dmitryshagin/gamma_5_bluetooth/hardware/wheel_decoder/decoder.brd

## EAGLE design hardware/wheel_decoder/decoder.brd (2017-07-10)

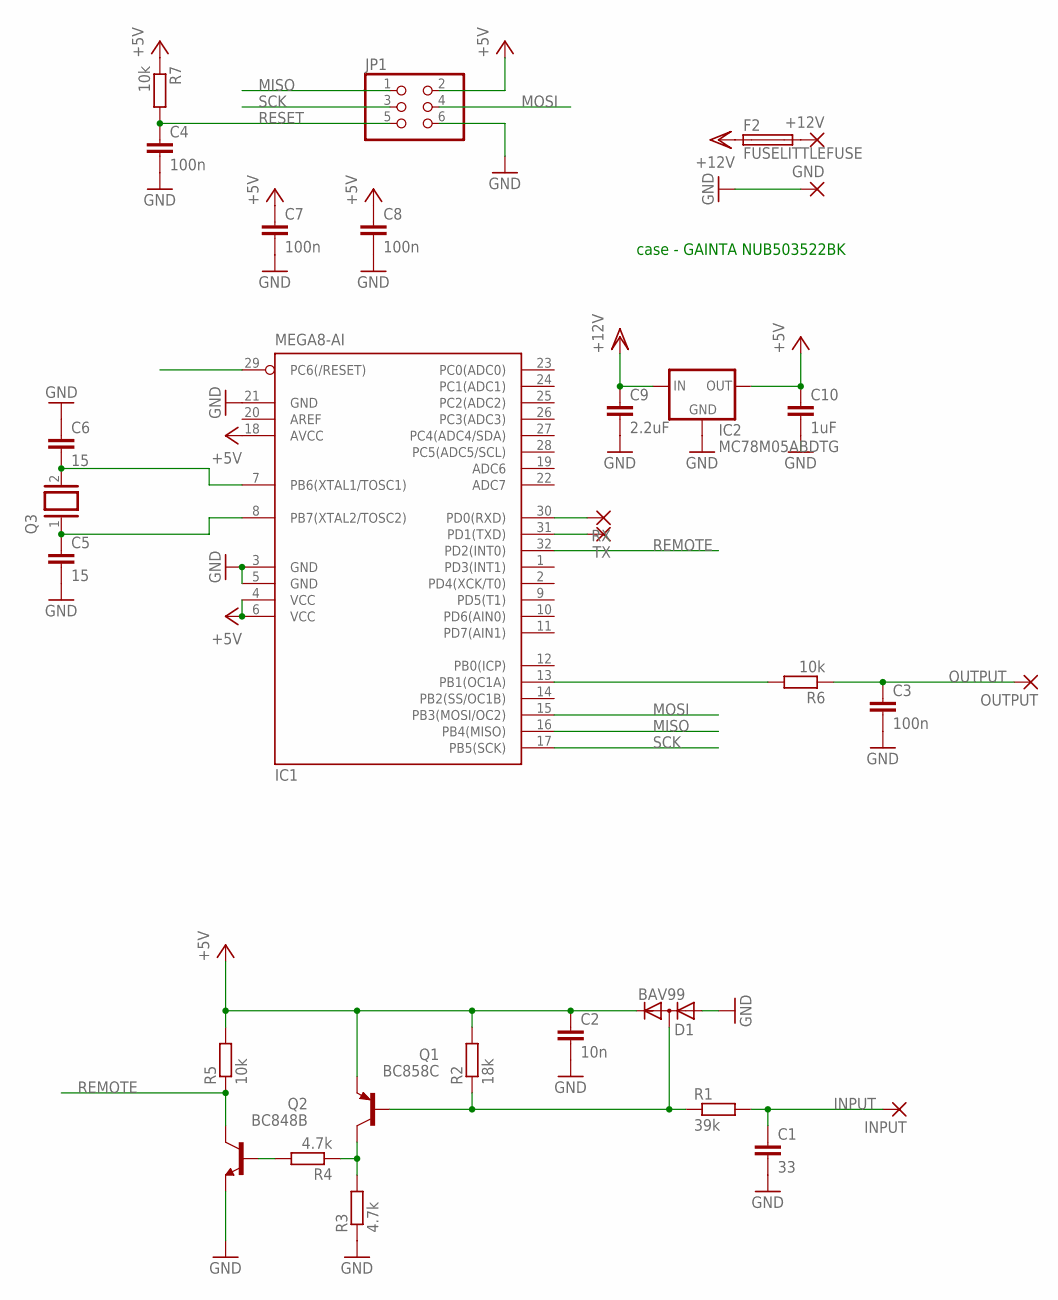
[picture p1: schematic decoder.sch]

Parts:
+12V: 3,81/1,4
C1: 33; C0603
C2: 10n; C0603
C3, C4, C7, C8: 100n; C0603
C5, C6: 15; C0603
C9: 2.2uF; C3225
C10: 1uF; C1206
D1: BAV99; SOT23
F2: FUSELITTLEFUSE; LITTLEFUSE
GND: 3,81/1,4
IC1: MEGA8-AI; TQFP32-08
IC2: MC78M05ABDTG; DPACK
INPUT: 2,54/1,1
JP1: PINHD-2X3; 2X03
OUTPUT: 2,54/1,1
Q1: BC858C; SOT23-BEC
Q2: BC848B; SOT23
Q3: XTAL/S; QS
R1: 39k; R0603
R2: 18k; R0603
R3, R4: 4.7k; R0603
R5, R6, R7: 10k; R0603
RX: 1,6/0,8
TX: 1,6/0,8

Connections:
GND: C1.2, C2.2, C3.2, C4.2, C5.2, C6.1, C7.2, C8.2, C9.2, C10.2, D1.1 (A), GND.1, IC1.3 (GND), IC1.5 (GND), IC1.21 (GND), IC2.4 (GND), JP1.6, Q2.2 (E), R3.1
INPUT: C1.1, INPUT.1, R1.2
MISO: IC1.16 (PB4(MISO)), JP1.1
MOSI: IC1.15 (PB3(MOSI/OC2)), JP1.4
unnamed: D1.3 (AC), Q1.B, R1.1, R2.1
unnamed: +12V.1, F2.2
unnamed: Q1.C, R3.2, R4.1
unnamed: Q2.1 (B), R4.2
unnamed: IC1.30 (PD0(RXD)), RX.1
unnamed: IC1.31 (PD1(TXD)), TX.1
unnamed: IC1.13 (PB1(OC1A)), R6.2
unnamed: C6.2, IC1.7 (PB6(XTAL1/TOSC1)), Q3.2
unnamed: C5.1, IC1.8 (PB7(XTAL2/TOSC2)), Q3.1
OUTPUT: C3.1, OUTPUT.1, R6.1
REMOTE: IC1.32 (PD2(INT0)), Q2.3 (C), R5.1
RESET: C4.1, IC1.29 (PC6(/RESET)), JP1.5, R7.2
SCK: IC1.17 (PB5(SCK)), JP1.3
VCC: C2.1, C7.1, C8.1, C10.1, D1.2 (C), IC1.4 (VCC), IC1.6 (VCC), IC1.18 (AVCC), IC2.3 (OUT), JP1.2, Q1.E, R2.2, R5.2, R7.1
VDD: C9.1, F2.1, IC2.1 (IN)

Notes on the sheet:
case - GAINTA NUB503522BK

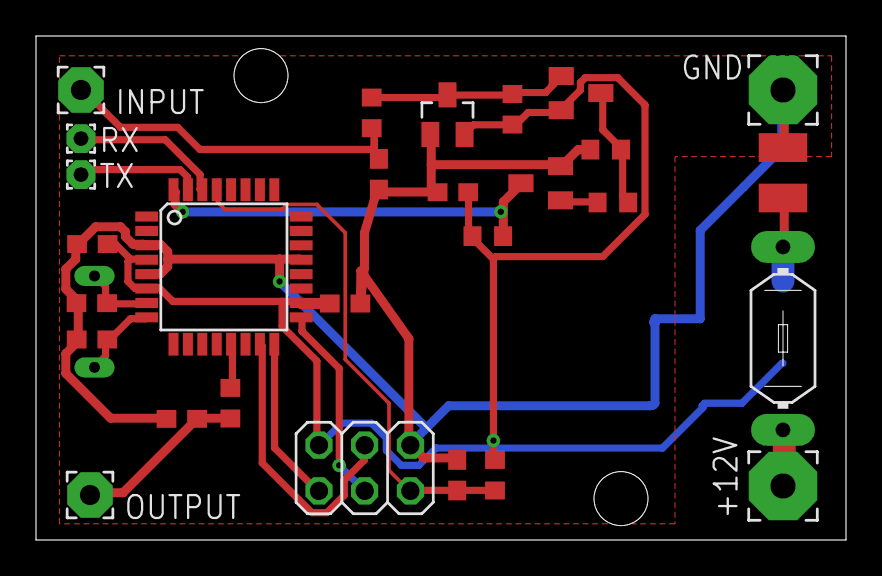
[picture p2: board decoder.brd from above]

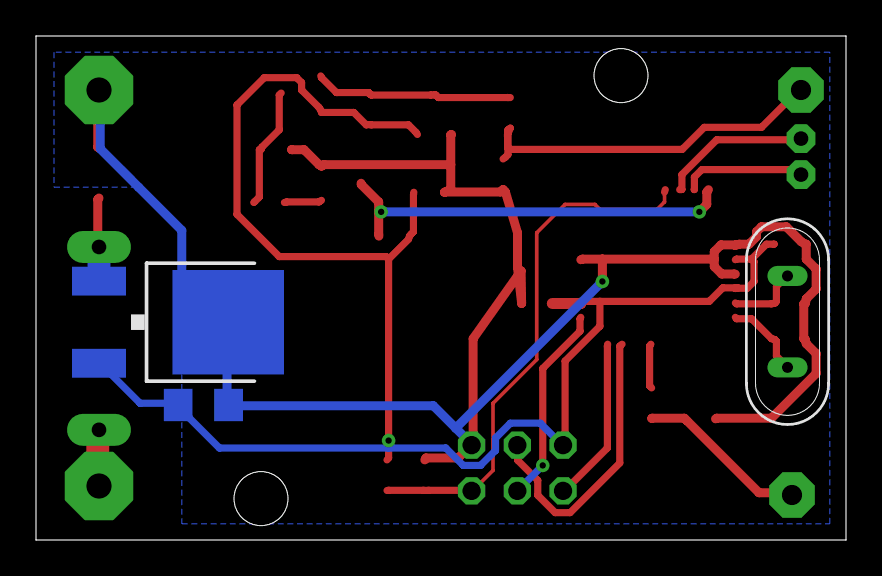
[picture p3: board decoder.brd from below]

Board: 2 copper layers, 45.0 x 28.0 mm, 31 parts (3 on the bottom side), 19 nets.
