dmitryshagin/gamma_5_bluetooth/hardware/car_bt.brd

## EAGLE design hardware/car_bt.brd (2016-06-21)

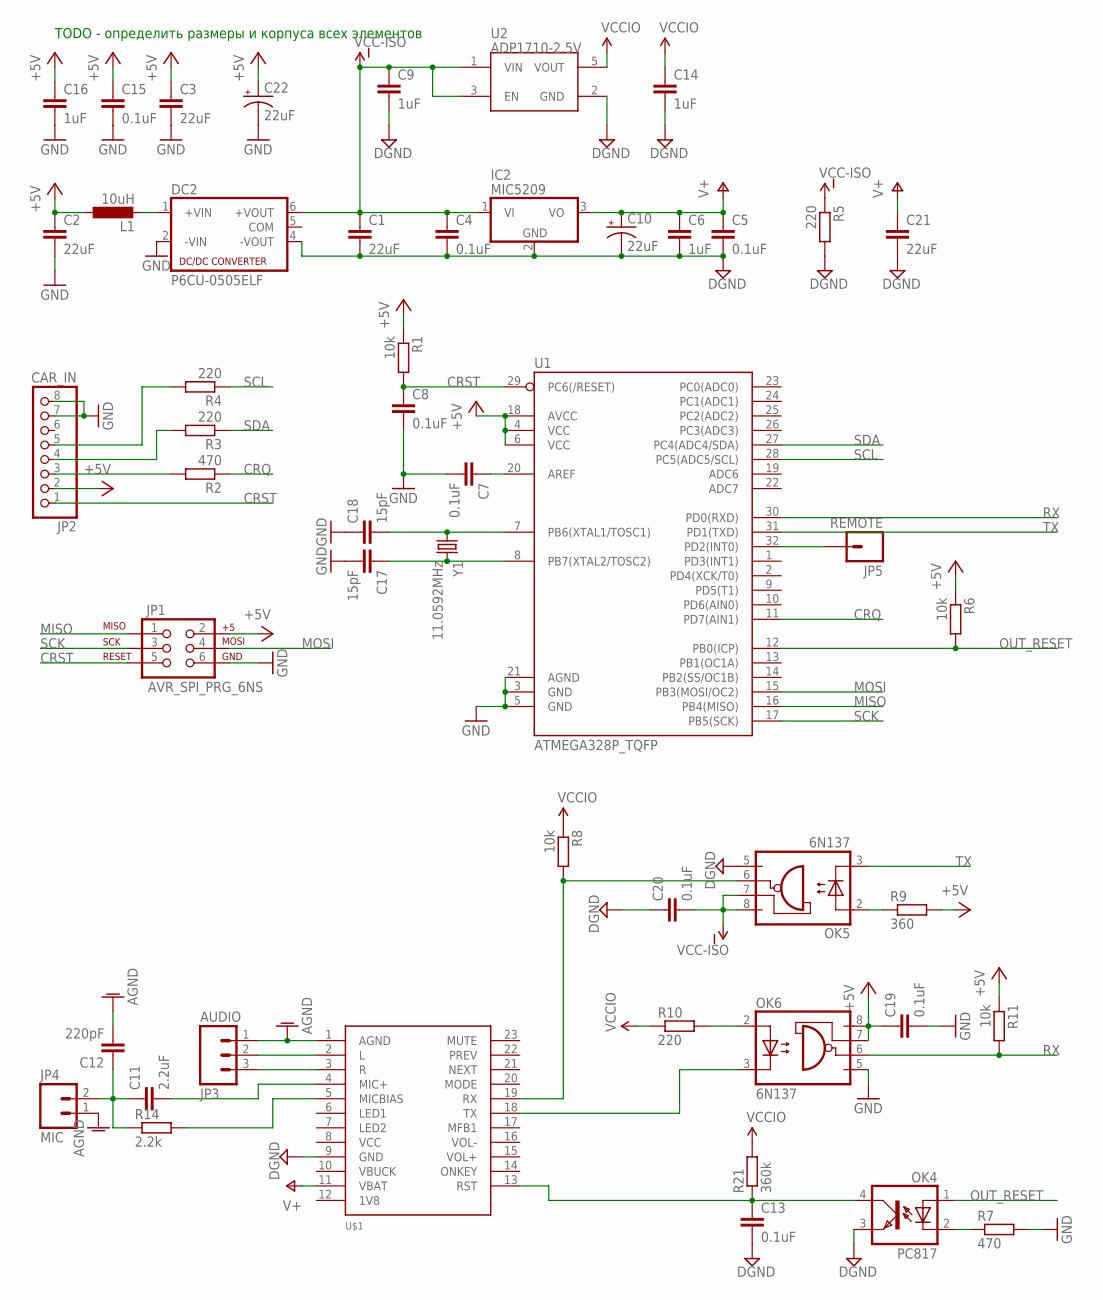
[picture p4: schematic car_bt.sch]

Parts:
C1, C2, C3, C21: 22uF; C1206
C4, C5, C7, C8, C13, C15, C19, C20: 0.1uF; C0805
C6, C9, C14, C16: 1uF; C0805
C10, C22: 22uF; EIA3528
C11: 2.2uF; C0805
C12: 220pF; C0805
C17, C18: 15pF; C0805
DC2: P6CU-0505ELF; NMA
IC2: MIC5209; SOT223
JP1: AVR_SPI_PRG_6NS; 2X3-NS
JP2: CAR_IN; 1X08/90
JP3: AUDIO; MOLEX-1X3
JP4: MIC; MOLEX-1X2_LOCK
JP5: REMOTE; 1X01_LONGPAD
L1: 10uH; L3216C
OK4: PC817; DIL04
OK5, OK6: 6N137; DIL08
R1, R6, R8, R11: 10k; R0805
R2, R7: 470; R0805
R3, R4, R5: 220; R0805
R9: 360; R0805
R10: 220; R1206
R14: 2.2k; R0805
R21: 360k; R0805
U1: ATMEGA328P_TQFP; TQFP32-08
U2: ADP1710-2.5V; SOT23-5
U$1: XS3868
Y1: 11.0592MHz; HC49U-V

Connections:
+5V: C2.1, C3.1, C15.1, C16.1, C19.1, C22.A (+), JP1.2, JP2.2, L1.1, OK6.7 (VE), OK6.8 (VCC), R1.1, R6.1, R9.2, R11.1, U1.4 (VCC), U1.6 (VCC), U1.18 (AVCC)
AGND: C12.2, JP3.1, JP4.1, U$1.1 (AGND)
CRQ: R2.1, U1.11 (PD7(AIN1))
CRST: C8.1, JP1.5, JP2.1, R1.2, U1.29 (PC6(/RESET))
DGND: C1.2, C4.2, C5.2, C6.2, C9.2, C10.C (-), C13.2, C14.2, C20.1, C21.2, DC2.4 (-VOUT), IC2.2 (GND), OK4.3 (EMIT), OK5.5 (GND), R5.2, U2.2 (GND), U$1.9 (GND)
GND: C2.2, C3.2, C7.2, C8.2, C15.2, C16.2, C17.2, C18.1, C19.2, C22.C (-), DC2.2 (-VIN), JP1.6, JP2.7, JP2.8, OK6.5 (GND), R7.2, U1.3 (GND), U1.5 (GND), U1.21 (AGND)
MISO: JP1.1, U1.16 (PB4(MISO))
MOSI: JP1.4, U1.15 (PB3(MOSI/OC2))
unnamed: JP2.3, R2.2
unnamed: JP2.4, R3.2
unnamed: JP2.5, R4.2
unnamed: DC2.1 (+VIN), L1.2
unnamed: OK6.3 (C), U$1.18 (TX)
unnamed: C7.1, U1.20 (AREF)
unnamed: C11.1, C12.1, JP4.2, R14.1
unnamed: JP3.2, U$1.2 (L)
unnamed: JP3.3, U$1.3 (R)
unnamed: JP5.1, U1.32 (PD2(INT0))
unnamed: OK5.2 (A), R9.1
unnamed: C13.1, OK4.4 (COL), R21.1, U$1.13 (RST)
unnamed: C17.1, U1.8 (PB7(XTAL2/TOSC2)), Y1.2
unnamed: OK5.6 (VO), R8.2, U$1.19 (RX)
unnamed: OK6.2 (A), R10.2
unnamed: C18.2, U1.7 (PB6(XTAL1/TOSC1)), Y1.1
unnamed: OK4.2 (C), R7.1
unnamed: C11.2, U$1.4 (MIC+)
unnamed: R14.2, U$1.5 (MICBIAS)
OUT_RESET: OK4.1 (A), R6.2, U1.12 (PB0(ICP))
RX: OK6.6 (VO), R11.2, U1.30 (PD0(RXD))
SCK: JP1.3, U1.17 (PB5(SCK))
SCL: R4.1, U1.28 (PC5(ADC5/SCL))
SDA: R3.1, U1.27 (PC4(ADC4/SDA))
TX: OK5.3 (C), U1.31 (PD1(TXD))
V+: C5.1, C6.1, C10.A (+), C21.1, IC2.3 (VO), U$1.11 (VBAT)
VCC-ISO: C1.1, C4.1, C9.1, C20.2, DC2.6 (+VOUT), IC2.1 (VI), OK5.7 (VE), OK5.8 (VCC), R5.1, U2.1 (VIN), U2.3 (EN)
VCCIO: C14.1, R8.1, R10.1, R21.2, U2.5 (VOUT)

Notes on the sheet:
TODO - определить размеры и корпуса всех элементов

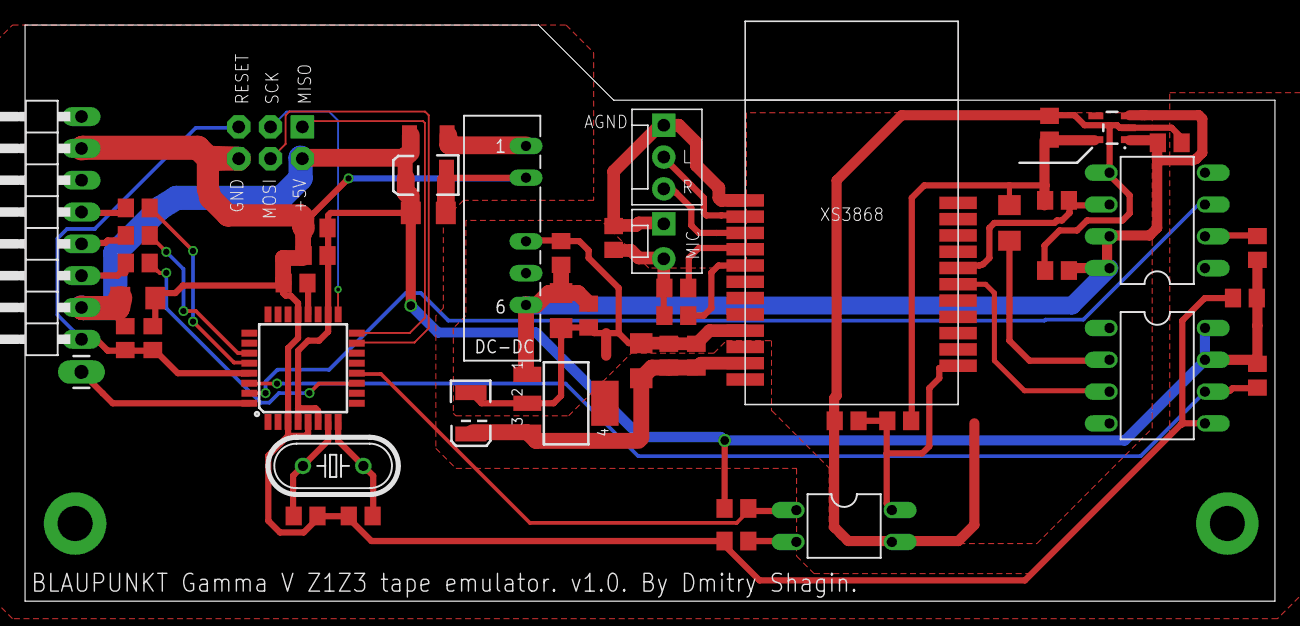
[picture p5: board car_bt.brd from above]

Board: 2 copper layers, 99.8 x 46.0 mm, 50 parts (0 on the bottom side), 36 nets.
