dmitryshagin/gamma_5_bluetooth/(commit log)

2016-05-13 selected components
    [car_bt.brd, car_bt.sch]
2016-05-15 v 1.0 of hardware completed
    [car_bt.GBL, car_bt.GBO, car_bt.GBP, car_bt.GBS, car_bt.GTL, car_bt.GTO, car_bt.GTP, car_bt.GTS]
2016-06-21 switched to uart
    [car_bt.brd, car_bt.sch]
2017-07-10 Added wheel decoder
    [decoder.GBL, decoder.GBO, decoder.GBP, decoder.GBS, decoder.GTL, decoder.GTO, decoder.GTP, decoder.GTS]
2017-08-14 Added PWM output to reciever
2018-05-13 Reciever now decodes to resistive load
2018-06-26 Added version for Arduino (9600 baud, 16Mhz crystal)
